motherdeveloper/mother-mls25-hw/README.rst

=====================
Mother MLS12 hardware
=====================

A 12W tunable-white LED driver, powered via PoE.
