motherdeveloper/mother-mls25-hw/pcb/mls25.kicad_pcb

## KiCad design pcb/mls25.kicad_pcb (2025-10-22)

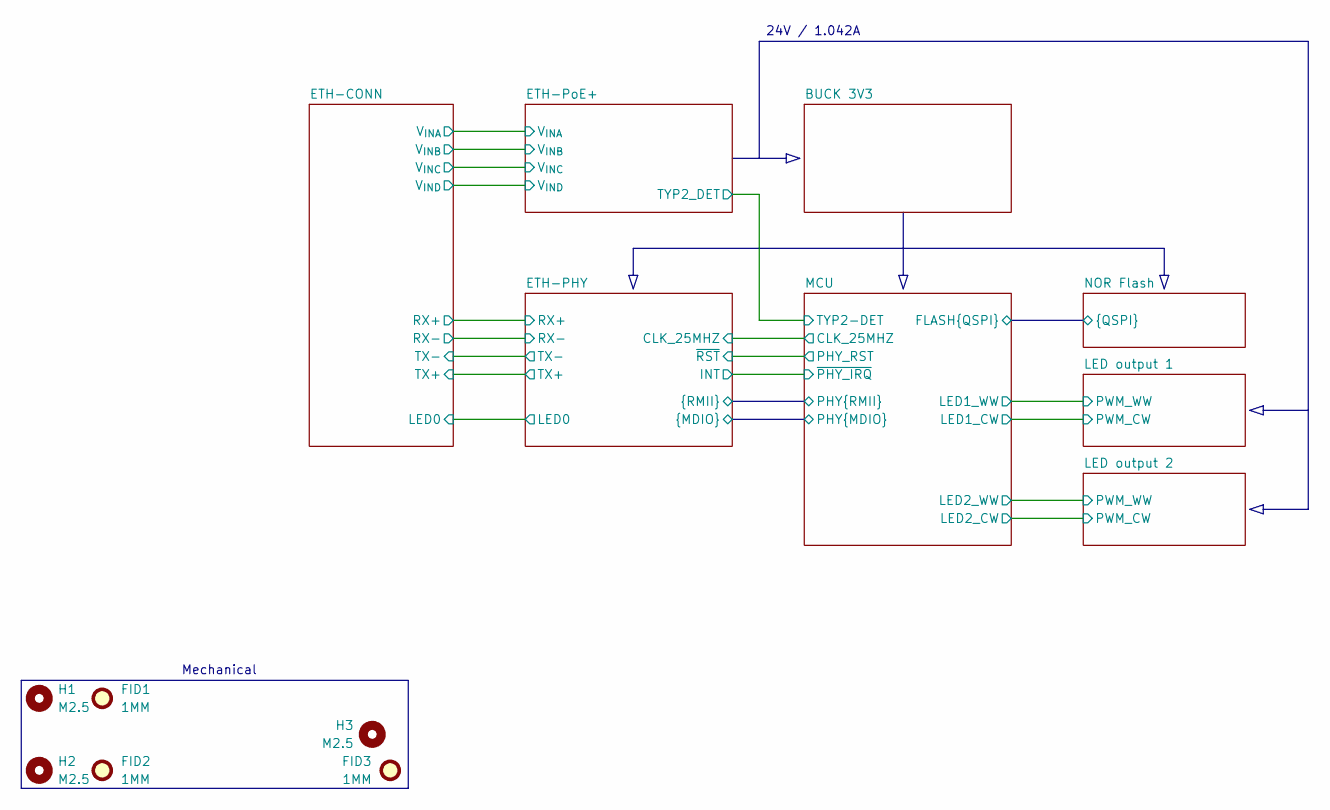
[picture p1: schematic mls25.kicad_sch, MLS25 — PoE+ LED driver]

Parts:
FID1, FID2, FID3: 1MM; Fiducial_1mm_Mask2mm
H1, H2, H3: M2.5; MountingHole_2.7mm_M2.5_ISO7380

Notes on the sheet:
24V / 1.042A
Mechanical

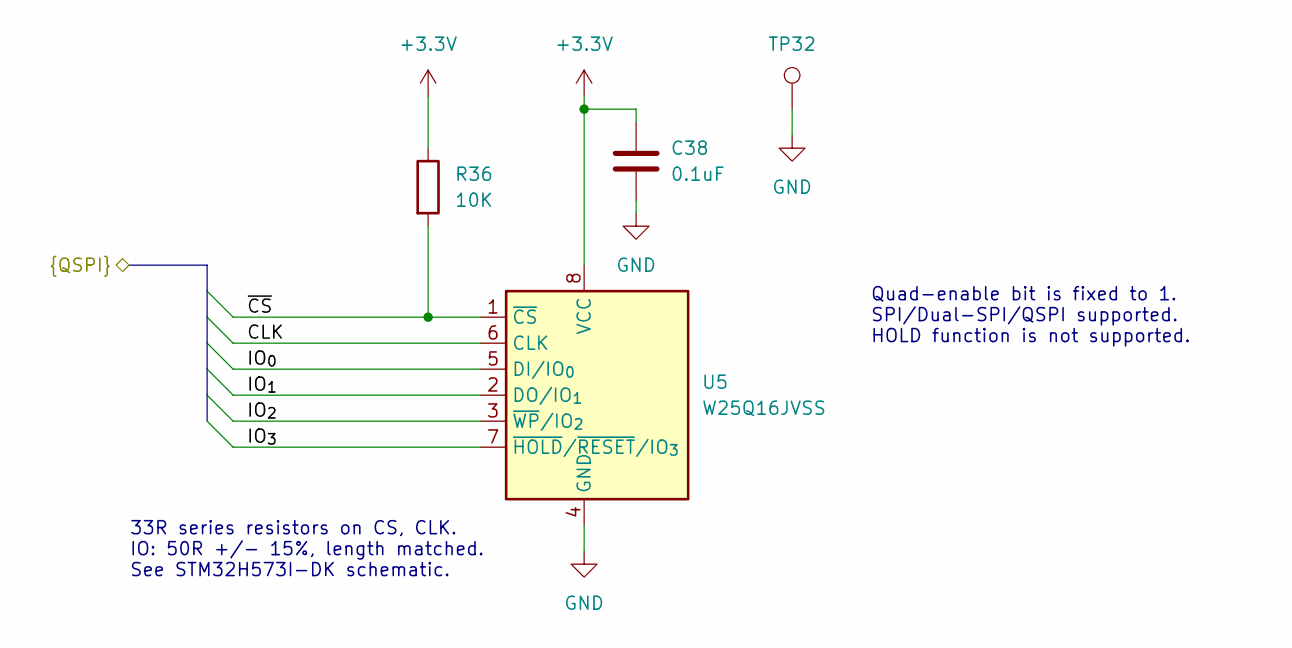
[picture p2: schematic mls25_nor_flash.kicad_sch, NOR flash memory]

Parts:
C38: 0.1uF; C_0603_1608Metric; MPN C0603C104M5RACAUTO
R36: 10K; R_0603_1608Metric; MPN AF0603FR-0710KL
TP32: TestPoint; TestPoint_Pad_1.5x1.5mm
U5: W25Q16JVSS; SOIC-8_5.3x5.3mm_P1.27mm; MPN W25Q16JVSSIQ

Connections:
+3.3V: C38.1, R36.1, U5.8 (VCC); also elsewhere on the board
/MCU/FLASH.CLK: U5.6 (CLK); also elsewhere on the board
/MCU/FLASH.IO_{0}: U5.5 (DI/IO_{0}); also elsewhere on the board
/MCU/FLASH.IO_{1}: U5.2 (DO/IO_{1}); also elsewhere on the board
/MCU/FLASH.IO_{2}: U5.3 (~WP/IO_{2}); also elsewhere on the board
/MCU/FLASH.IO_{3}: U5.7 (~HOLD/~RESET/IO_{3}); also elsewhere on the board
/MCU/FLASH.~CS: R36.2, U5.1 (~CS); also elsewhere on the board
GND: C38.2, TP32.1, U5.4 (GND); also elsewhere on the board

Notes on the sheet:
33R series resistors on CS, CLK. IO: 50R +/- 15%, length matched. See STM32H573I-DK schematic.
Quad-enable bit is fixed to 1. SPI/Dual-SPI/QSPI supported. HOLD function is not supported.

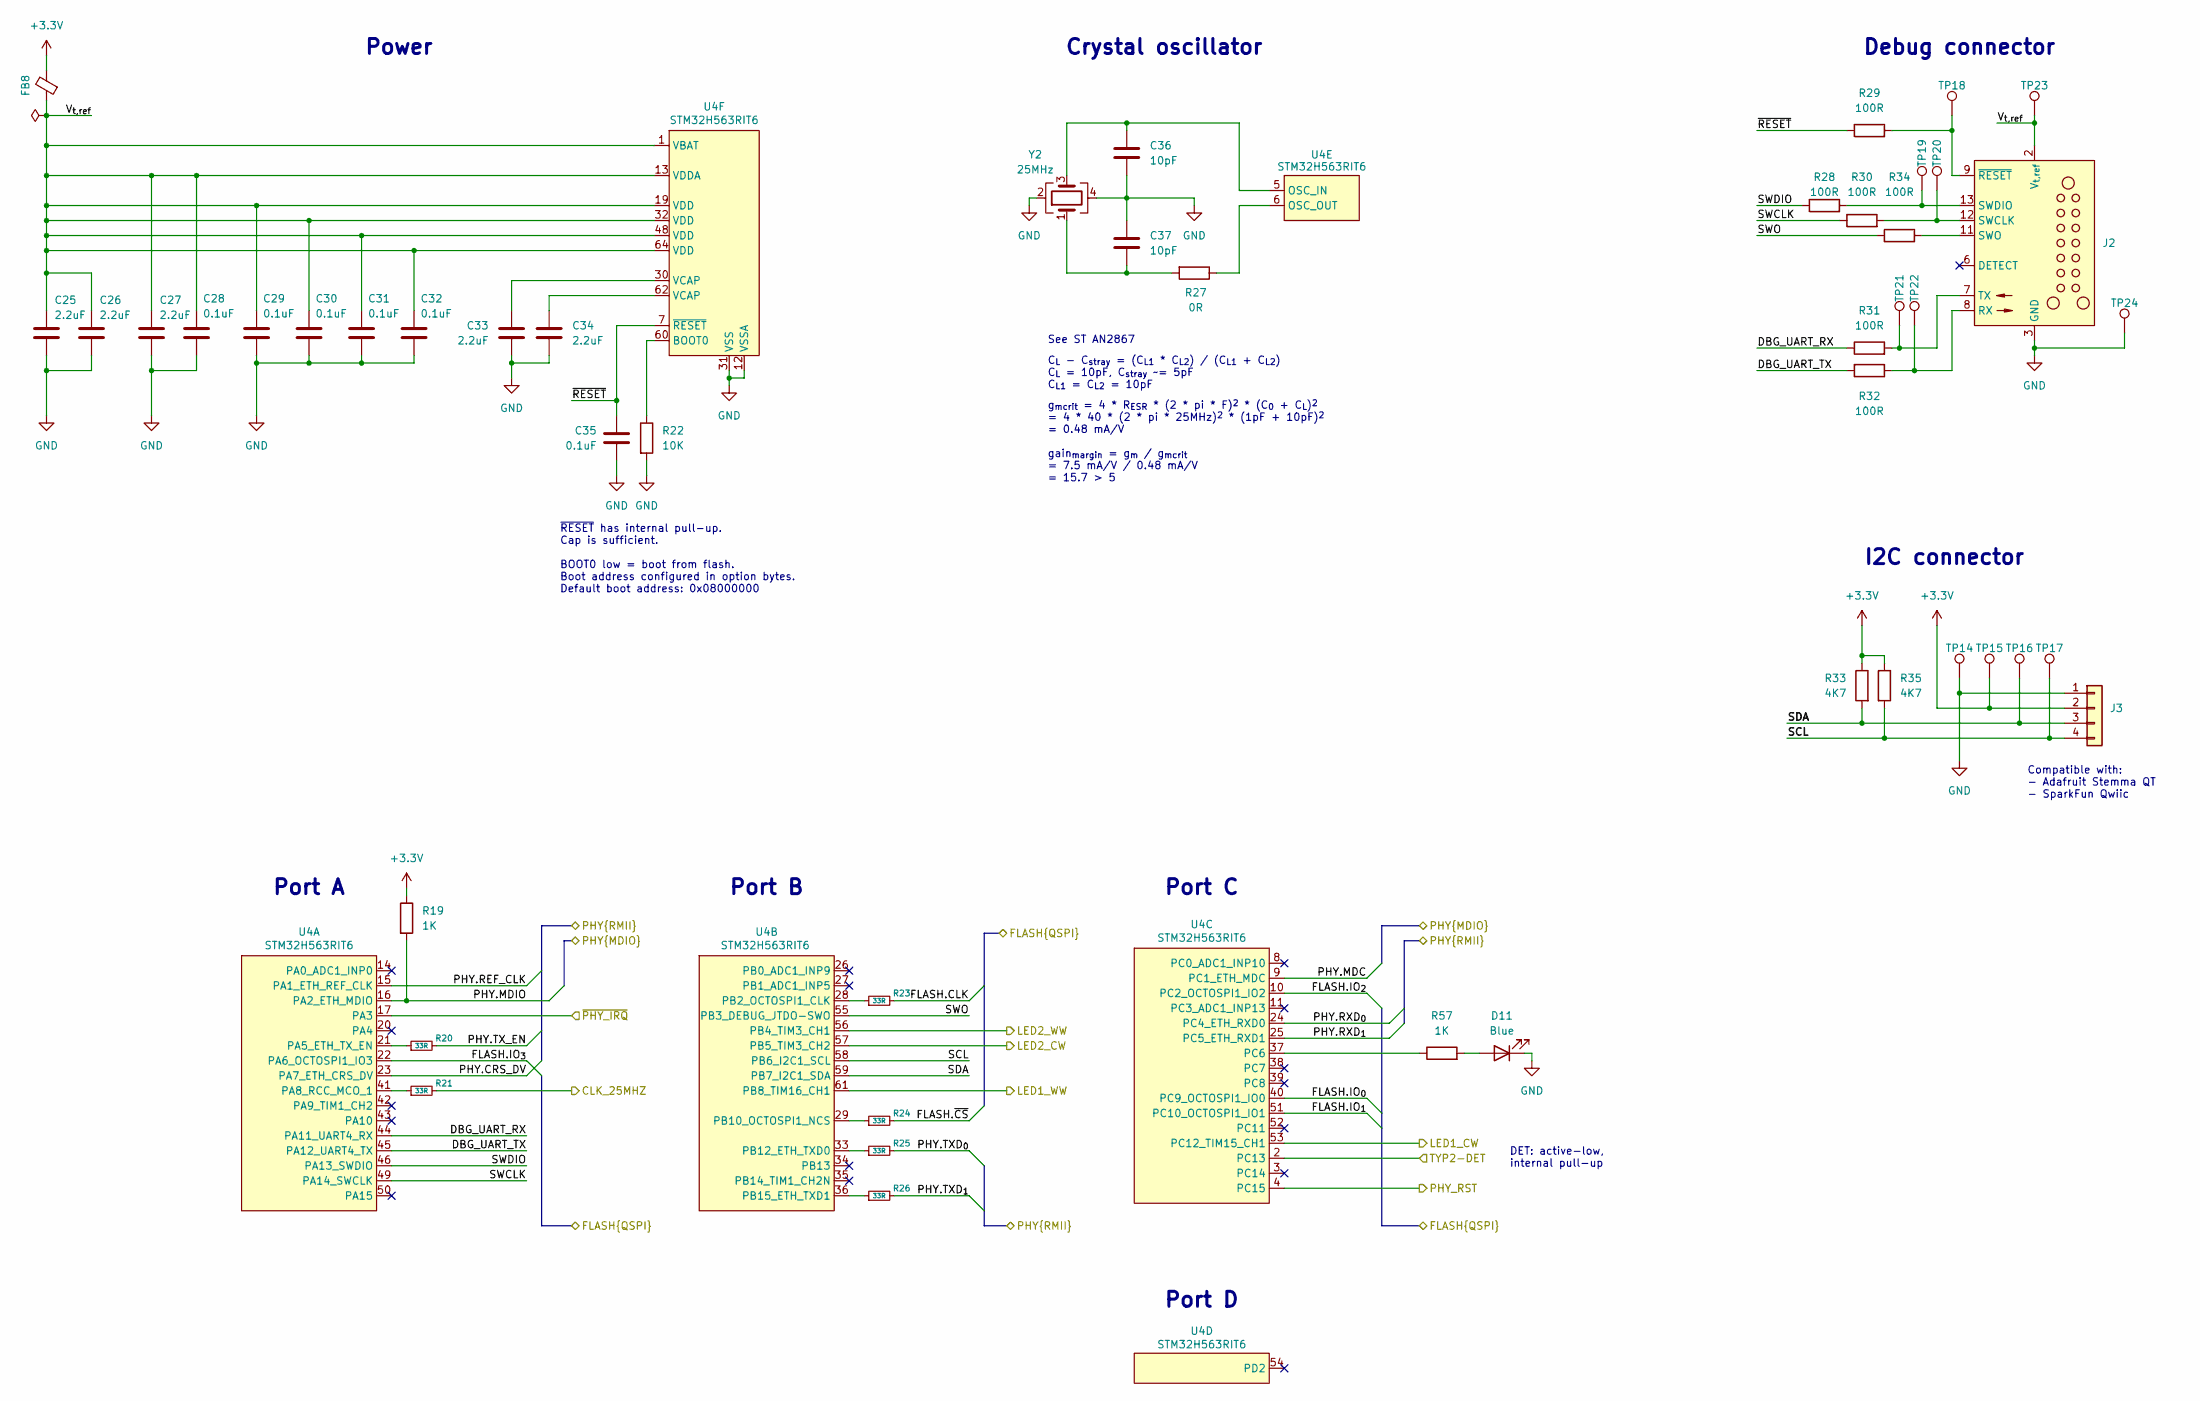
[picture p3: schematic mls25_mcu.kicad_sch, Microcontroller]

Parts:
C25, C26, C27, C33, C34: 2.2uF; C_0603_1608Metric; MPN CL10A225KQ8NNNC
C28, C29, C30, C31, C32, C35: 0.1uF; C_0603_1608Metric; MPN C0603C104M5RACAUTO
C36, C37: 10pF; C_0603_1608Metric; MPN 0603N100J100CT
D11: Blue; LED_0603_1608Metric; MPN LTST-C193TBKT-5A
FB8: FerriteBead_Small; L_0805_2012Metric; MPN MPZ2012S102AT000
J2: TC2070-FP; Tag-Connect_TC2070-IDC-FP_2x07_P1.27mm_Vertical; MPN TC2070-IDC-FP
J3: SM04B-SRSS-TB; JST_SH_SM04B-SRSS-TB_1x04-1MP_P1.00mm_Horizontal; MPN SM04B-SRSS-TB
R19, R57: 1K; R_0603_1608Metric; MPN AC0603JR-131KL
R20, R21, R23, R24, R25, R26: 33R; R_0603_1608Metric; MPN WR06X330 JTL
R22: 10K; R_0603_1608Metric; MPN AF0603FR-0710KL
R27: 0R; R_0603_1608Metric; MPN RC0603JR-100RL
R28, R29, R30, R31, R32, R34: 100R; R_0603_1608Metric; MPN RC0603JR-10100RL
R33, R35: 4K7; R_0603_1608Metric; MPN RC0603JR-134K7L
TP14, TP24: TestPoint; TestPoint_Pad_1.5x1.5mm
TP15, TP16, TP17, TP18, TP19, TP20, TP21, TP22, TP23: TestPoint; TestPoint_Pad_D1.5mm
U4: STM32H563RIT6; LQFP-64_10x10mm_P0.5mm; MPN STM32H563RIT6
Y2: 25MHz; Crystal_SMD_3225-4Pin_3.2x2.5mm; MPN CX3225FB25000F0FZZH1

Connections:
+3.3V: FB8.2, J3.2, R19.1, R33.1, R35.1, TP15.1; also elsewhere on the board
/ETH-PHY/CLK_25MHZ: R21.2; also elsewhere on the board
/ETH-PHY/CRS_DV: U4.23 (PA7_ETH_CRS_DV); also elsewhere on the board
/ETH-PHY/INT: U4.17 (PA3); also elsewhere on the board
/ETH-PHY/MDC: U4.9 (PC1_ETH_MDC); also elsewhere on the board
/ETH-PHY/MDIO: R19.2, U4.16 (PA2_ETH_MDIO); also elsewhere on the board
/ETH-PHY/REF_CLK: U4.15 (PA1_ETH_REF_CLK); also elsewhere on the board
/ETH-PHY/RXD_{0}: U4.24 (PC4_ETH_RXD0); also elsewhere on the board
/ETH-PHY/RXD_{1}: U4.25 (PC5_ETH_RXD1); also elsewhere on the board
/ETH-PHY/TXD_{0}: R25.2; also elsewhere on the board
/ETH-PHY/TXD_{1}: R26.2; also elsewhere on the board
/ETH-PHY/TX_EN: R20.2; also elsewhere on the board
/ETH-PHY/~RST: U4.4 (PC15); also elsewhere on the board
/ETH-PoE+/TYP2_DET: U4.2 (PC13); also elsewhere on the board
/LED output 1/PWM_CW: U4.53 (PC12_TIM15_CH1); also elsewhere on the board
/LED output 1/PWM_WW: U4.61 (PB8_TIM16_CH1); also elsewhere on the board
/LED output 2/PWM_CW: U4.57 (PB5_TIM3_CH2); also elsewhere on the board
/LED output 2/PWM_WW: U4.56 (PB4_TIM3_CH1); also elsewhere on the board
/MCU/DBG_UART_RX: R31.1, U4.44 (PA11_UART4_RX)
/MCU/DBG_UART_TX: R32.2, U4.45 (PA12_UART4_TX)
/MCU/FLASH.CLK: R23.2; also elsewhere on the board
/MCU/FLASH.IO_{0}: U4.40 (PC9_OCTOSPI1_IO0); also elsewhere on the board
/MCU/FLASH.IO_{1}: U4.51 (PC10_OCTOSPI1_IO1); also elsewhere on the board
/MCU/FLASH.IO_{2}: U4.10 (PC2_OCTOSPI1_IO2); also elsewhere on the board
/MCU/FLASH.IO_{3}: U4.22 (PA6_OCTOSPI1_IO3); also elsewhere on the board
/MCU/FLASH.~CS: R24.2; also elsewhere on the board
/MCU/SCL: J3.4, R35.2, TP17.1, U4.58 (PB6_I2C1_SCL)
/MCU/SDA: J3.3, R33.2, TP16.1, U4.59 (PB7_I2C1_SDA)
/MCU/SWCLK: R30.1, U4.49 (PA14_SWCLK)
/MCU/SWDIO: R28.1, U4.46 (PA13_SWDIO)
/MCU/SWO: R34.1, U4.55 (PB3_DEBUG_JTDO-SWO)
/MCU/V_{t,ref}: C25.1, C26.1, C27.1, C28.1, C29.1, C30.1, C31.1, C32.1, FB8.1, J2.2 (V_{t,ref}), TP23.1, U4.1 (VBAT), U4.13 (VDDA), U4.19 (VDD), U4.32 (VDD), U4.48 (VDD), U4.64 (VDD)
/MCU/~RESET: C35.1, R29.1, U4.7 (~RESET)
GND: C25.2, C26.2, C27.2, C28.2, C29.2, C30.2, C31.2, C32.2, C33.2, C34.2, C35.2, C36.2, C37.1, D11.1 (K), J2.3 (GND), J2.4 (GND), J3.1, R22.2, TP14.1, TP24.1, U4.12 (VSSA), U4.18 (VSSA), U4.31 (VSS), U4.47 (VSS), U4.63 (VSS), Y2.2, Y2.4; also elsewhere on the board
unnamed: C33.1, U4.30 (VCAP)
unnamed: C34.1, U4.62 (VCAP)
unnamed: C37.2, R27.2, Y2.1
unnamed: D11.2 (A), R57.2
unnamed: J2.8 (RX), R32.1, TP22.1
unnamed: J2.12 (SWCLK), R30.2, TP20.1
unnamed: J2.13 (SWDIO), R28.2, TP19.1
unnamed: J2.11 (SWO), R34.2
unnamed: J2.7 (TX), R31.2, TP21.1
unnamed: J2.9 (~RESET), R29.2, TP18.1
unnamed: R20.1, U4.21 (PA5_ETH_TX_EN)
unnamed: R21.1, U4.41 (PA8_RCC_MCO_1)
unnamed: R23.1, U4.28 (PB2_OCTOSPI1_CLK)
unnamed: R24.1, U4.29 (PB10_OCTOSPI1_NCS)
unnamed: R25.1, U4.33 (PB12_ETH_TXD0)
unnamed: R26.1, U4.36 (PB15_ETH_TXD1)
unnamed: R57.1, U4.37 (PC6)
unnamed: C36.1, U4.5 (OSC_IN), Y2.3
unnamed: R27.1, U4.6 (OSC_OUT)
unnamed: R22.1, U4.60 (BOOT0)

Notes on the sheet:
C_{L} - C_{stray} = (C_{L1} * C_{L2}) / (C_{L1} + C_{L2}) C_{L} = 10pF, C_{stray} ~= 5pF C_{L1} = C_{L2} = 10pF
See ST AN2867
I2C connector
g_{mcrit} = 4 * R_{ESR} * (2 * pi * F)^{2} * (C_{0} + C_{L})^{2} = 4 * 40 * (2 * pi * 25MHz)^{2} * (1pF + 10pF)^{2} = 0.48 mA/V gain_{margin} = g_{m} / g_{mcrit} = 7.5 mA/V / 0.48 mA/V = 15.7 > 5
Debug connector
Crystal oscillator
Power
Port A
Compatible with: - Adafruit Stemma QT - SparkFun Qwiic
Port D
Port C
Port B
DET: active-low, internal pull-up
~{RESET} has internal pull-up. Cap is sufficient. BOOT0 low = boot from flash. Boot address configured in option bytes. Default boot address: 0x08000000

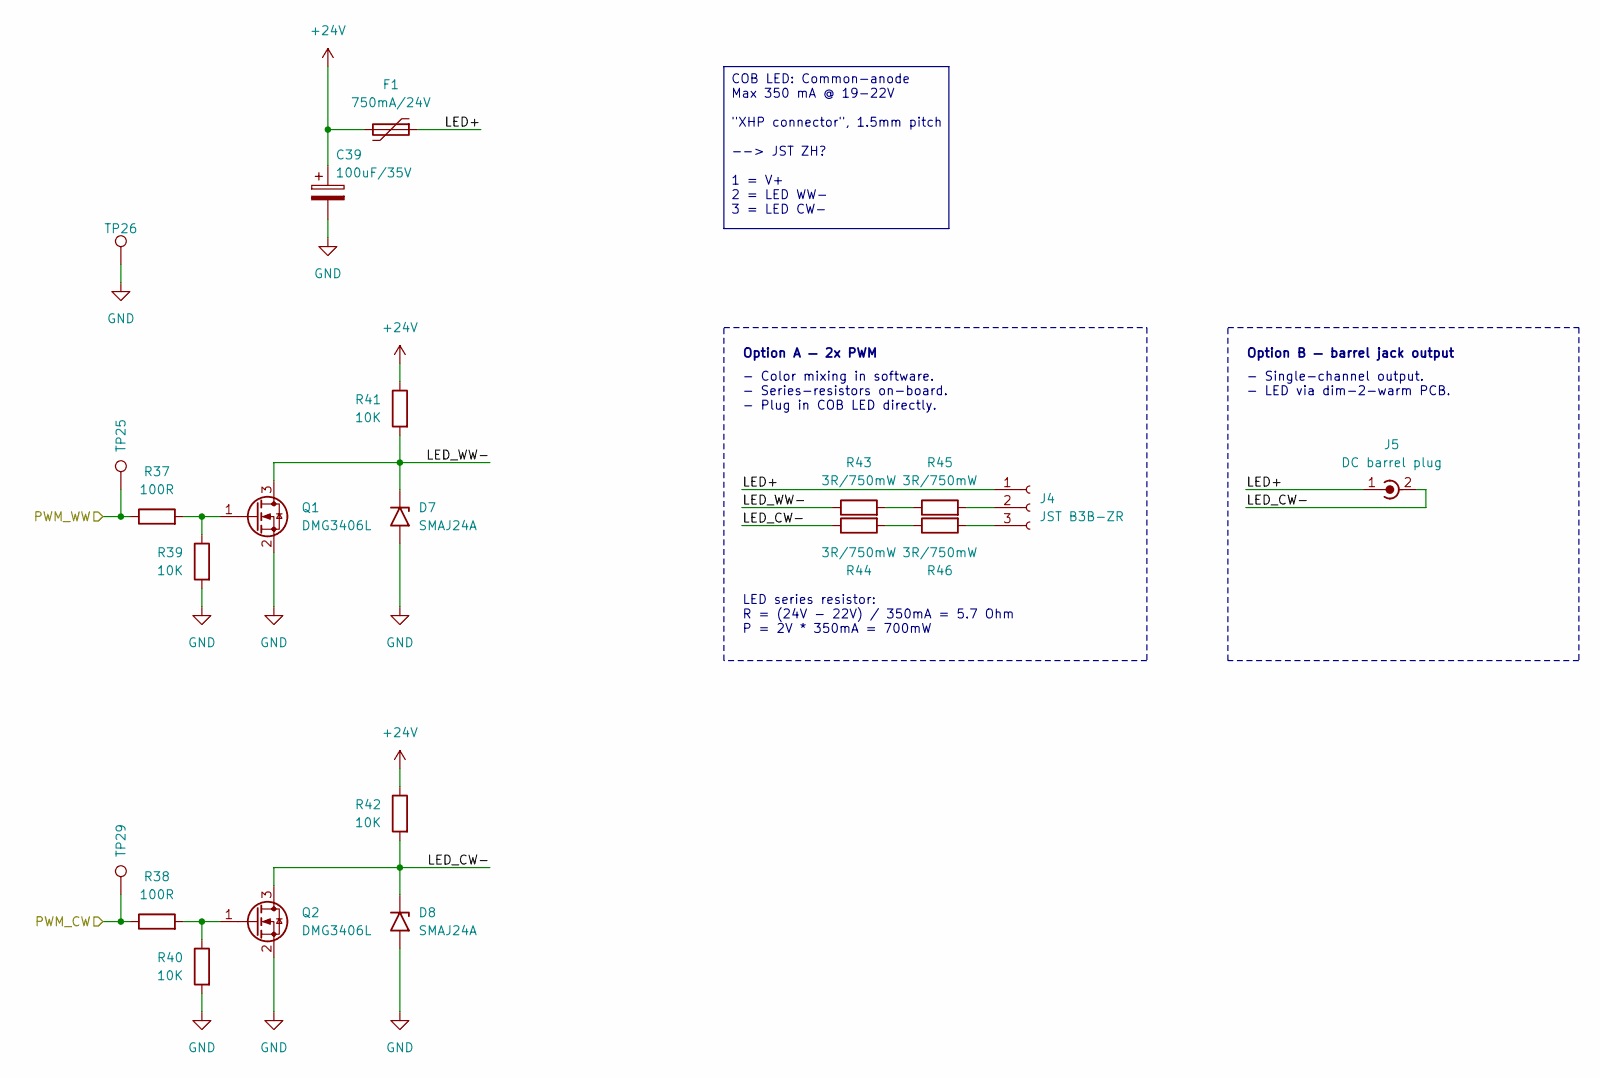
[picture p4: schematic mls25_led_output.kicad_sch, LED output]

Parts:
C39: 100uF/35V; CP_Elec_6.3x5.9; MPN 865080545012
D7, D8: SMAJ24A; D_SMA; MPN SMBJ24A/TR13
F1: 750mA/24V; SMD1812B050TF_30; MPN SMD1812B075TF/24
J4: JST B3B-ZR; JST_ZH_B3B-ZR_1x03_P1.50mm_Vertical; MPN B3B-ZR
J5: DC barrel plug; DC_Barrel_Plug_2.1x5.5mm
Q1, Q2: DMG3406L; SOT-23; MPN DMG3406L-13
R37, R38: 100R; R_0603_1608Metric; MPN RC0603JR-10100RL
R39, R40, R41, R42: 10K; R_0603_1608Metric; MPN AF0603FR-0710KL
R43, R44, R45, R46: 3R/750mW; R_1206_3216Metric; MPN ESR18EZPF3R00
TP25, TP29: TestPoint; TestPoint_Pad_D1.5mm
TP26: TestPoint; TestPoint_Pad_1.5x1.5mm

Connections:
+24V: C39.1, F1.2, R41.1, R42.1; also elsewhere on the board
/LED output 1/LED+: F1.1, J4.1, J5.1 (In)
/LED output 1/LED_CW-: D8.1 (A1), J5.2 (Ext), Q2.3 (D), R42.2, R44.1
/LED output 1/LED_WW-: D7.1 (A1), Q1.3 (D), R41.2, R43.1
/LED output 1/PWM_CW: R38.1, TP29.1; also elsewhere on the board
/LED output 1/PWM_WW: R37.1, TP25.1; also elsewhere on the board
GND: C39.2, D7.2 (A2), D8.2 (A2), Q1.2 (S), Q2.2 (S), R39.2, R40.2, TP26.1; also elsewhere on the board
unnamed: J4.2, R45.2
unnamed: J4.3, R46.2
unnamed: Q1.1 (G), R37.2, R39.1
unnamed: Q2.1 (G), R38.2, R40.1
unnamed: R43.2, R45.1
unnamed: R44.2, R46.1

Parts of its further copies:
C40: 100uF/35V; CP_Elec_6.3x5.9; MPN 865080545012
D9, D10: SMAJ24A; D_SMA; MPN SMBJ24A/TR13
F2: 750mA/24V; SMD1812B050TF_30; MPN SMD1812B075TF/24
J6: JST B3B-ZR; JST_ZH_B3B-ZR_1x03_P1.50mm_Vertical; MPN B3B-ZR
J7: DC barrel plug; DC_Barrel_Plug_2.1x5.5mm
Q3, Q4: DMG3406L; SOT-23; MPN DMG3406L-13
R47, R48: 100R; R_0603_1608Metric; MPN RC0603JR-10100RL
R49, R50, R51, R52: 10K; R_0603_1608Metric; MPN AF0603FR-0710KL
R53, R54, R55, R56: 3R/750mW; R_1206_3216Metric; MPN ESR18EZPF3R00
TP27, TP30: TestPoint; TestPoint_Pad_D1.5mm
TP28: TestPoint; TestPoint_Pad_1.5x1.5mm

Connections of its further copies:
+24V: C40.1, F2.2, R51.1, R52.1; also elsewhere on the board
/LED output 2/LED+: F2.1, J6.1, J7.1 (In)
/LED output 2/LED_CW-: D10.1 (A1), J7.2 (Ext), Q4.3 (D), R52.2, R54.1
/LED output 2/LED_WW-: D9.1 (A1), Q3.3 (D), R51.2, R53.1
/LED output 2/PWM_CW: R48.1, TP30.1; also elsewhere on the board
/LED output 2/PWM_WW: R47.1, TP27.1; also elsewhere on the board
GND: C40.2, D9.2 (A2), D10.2 (A2), Q3.2 (S), Q4.2 (S), R49.2, R50.2, TP28.1; also elsewhere on the board
unnamed: J6.2, R55.2
unnamed: J6.3, R56.2
unnamed: Q3.1 (G), R47.2, R49.1
unnamed: Q4.1 (G), R48.2, R50.1
unnamed: R53.2, R55.1
unnamed: R54.2, R56.1

Notes on the sheet:
Option A — 2x PWM
- Color mixing in software. - Series-resistors on-board. - Plug in COB LED directly.
LED series resistor: R = (24V - 22V) / 350mA = 5.7 Ohm P = 2V * 350mA = 700mW
Option B — barrel jack output
- Single-channel output. - LED via dim-2-warm PCB.
COB LED: Common-anode Max 350 mA @ 19-22V "XHP connector", 1.5mm pitch --> JST ZH? 1 = V+ 2 = LED WW- 3 = LED CW-

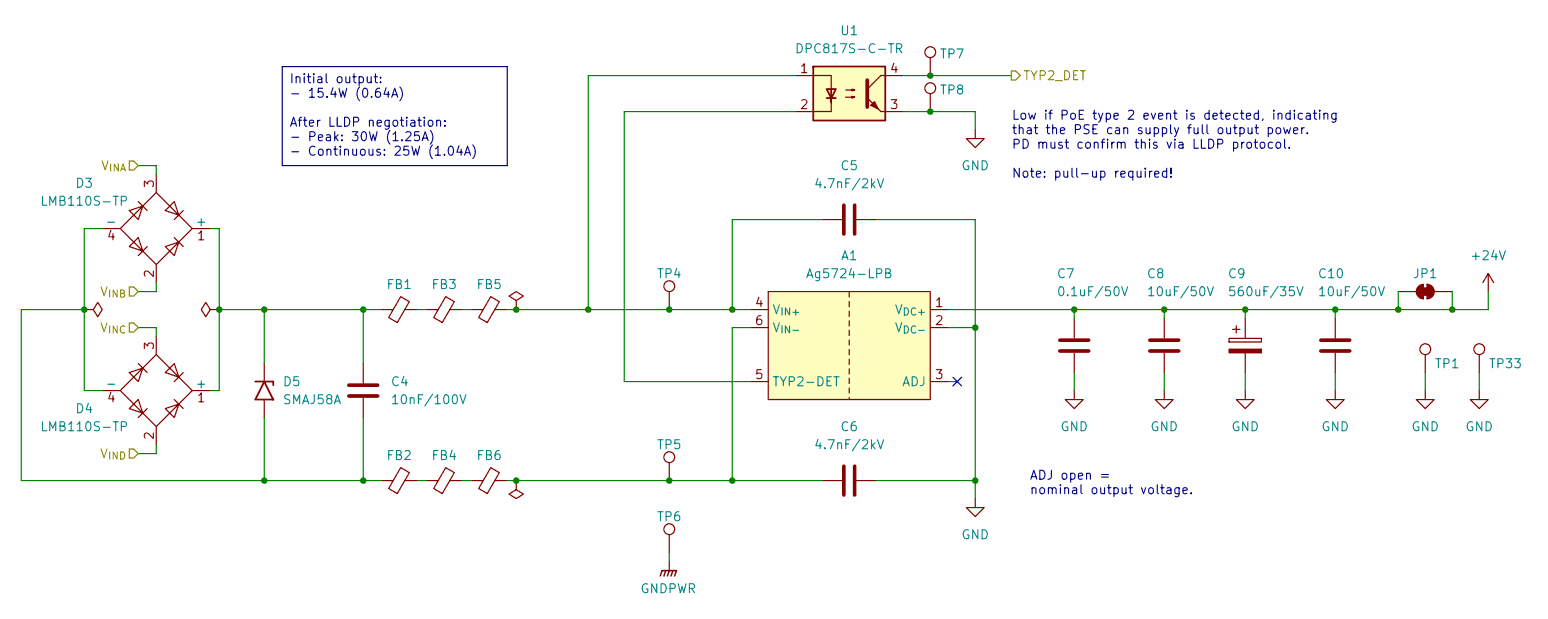
[picture p5: schematic mls25_eth_poe.kicad_sch, Power-over-Ethernet]

Parts:
A1: Ag5724-LPB; MPN Ag5724-LPB
C4: 10nF/100V; C_0603_1608Metric; MPN CGA3E2X7R2A103K080AA
C5, C6: 4.7nF/2kV; C_1210_3225Metric; MPN 1210B472K202CT
C7: 0.1uF/50V; C_0603_1608Metric; MPN C0603C104M5RACAUTO
C8, C10: 10uF/50V; C_1206_3216Metric; MPN 1206X106K500CT
C9: 560uF/35V; CP_Elec_10x10.5; MPN EMZS350ARA561MJA0G
D3, D4: LMB110S-TP; MPN LMB110S-TP
D5: SMAJ58A; D_SMA; MPN SMAJ58A/TR13
FB1, FB2, FB3, FB4, FB5, FB6: FerriteBead_Small; L_0805_2012Metric; MPN MPZ2012S102AT000
JP1: SolderJumper_2_Bridged; SolderJumper-2_P1.3mm_Bridged_RoundedPad1.0x1.5mm
TP1, TP6, TP8, TP33: TestPoint; TestPoint_Pad_1.5x1.5mm
TP4, TP5, TP7: TestPoint; TestPoint_Pad_D1.5mm
U1: DPC817S-C-TR; MPN DPC817S-C-TR

Connections:
+24V: A1.1 (V_{DC+}), C7.1, C8.1, C9.1, C10.1, JP1.1 (A), JP1.2 (B); also elsewhere on the board
/ETH-CONN/V_{INA}: D3.3; also elsewhere on the board
/ETH-CONN/V_{INB}: D3.2; also elsewhere on the board
/ETH-CONN/V_{INC}: D4.3; also elsewhere on the board
/ETH-CONN/V_{IND}: D4.2; also elsewhere on the board
/ETH-PoE+/TYP2_DET: TP7.1, U1.4; also elsewhere on the board
GND: A1.2 (V_{DC-}), C5.2, C6.2, C7.2, C8.2, C9.2, C10.2, TP1.1, TP8.1, TP33.1, U1.3; also elsewhere on the board
GNDPWR: TP6.1; also elsewhere on the board
unnamed: A1.5 (TYP2-DET), U1.2
unnamed: A1.4 (V_{IN+}), C5.1, FB5.2, TP4.1, U1.1
unnamed: A1.6 (V_{IN-}), C6.1, FB6.2, TP5.1
unnamed: C4.1, D3.1 (+), D4.1 (+), D5.1 (A1), FB1.1
unnamed: C4.2, D3.4 (-), D4.4 (-), D5.2 (A2), FB2.1
unnamed: FB1.2, FB3.1
unnamed: FB2.2, FB4.1
unnamed: FB3.2, FB5.1
unnamed: FB4.2, FB6.1

Notes on the sheet:
Low if PoE type 2 event is detected, indicating that the PSE can supply full output power. PD must confirm this via LLDP protocol. Note: pull-up required!
ADJ open = nominal output voltage.
Initial output: - 15.4W (0.64A) After LLDP negotiation: - Peak: 30W (1.25A) - Continuous: 25W (1.04A)

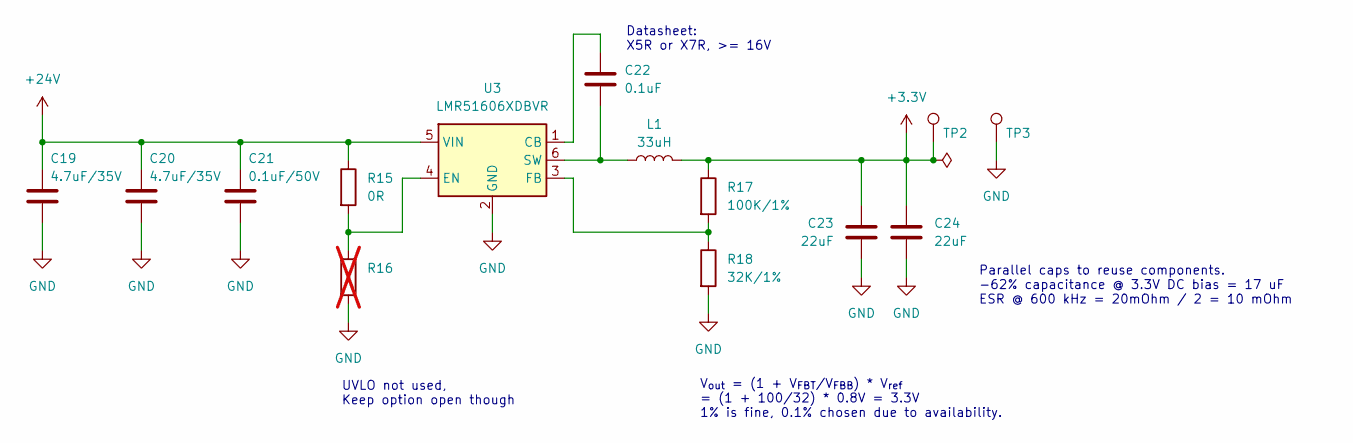
[picture p6: schematic mls25_buck_3v3.kicad_sch, 3.3V buck-converter]

Parts:
C19, C20: 4.7uF/35V; C_0603_1608Metric; MPN C1608X5R1V475K080AC
C21: 0.1uF/50V; C_0603_1608Metric; MPN C0603C104M5RACAUTO
C22: 0.1uF; C_0603_1608Metric; MPN C0603C104M5RACAUTO
C23, C24: 22uF; C_0603_1608Metric; MPN GRM188R60J226MEA0J
L1: 33uH; L_Taiyo-Yuden_NR-60xx; MPN NRS6045T330MMGK
R15: 0R; R_0603_1608Metric; MPN RC0603JR-100RL
R16: R_0603_1608Metric; not fitted
R17: 100K/1%; R_0603_1608Metric; MPN RT0603FRE13100KL
R18: 32K/1%; R_0603_1608Metric; MPN RT0603BRD0732KL
TP2: TestPoint; TestPoint_Pad_D1.5mm
TP3: TestPoint; TestPoint_Pad_1.5x1.5mm
U3: LMR51606XDBVR; LMR51606_SOT-23-6; MPN LMR51606XDBVR

Connections:
+3.3V: C23.1, C24.1, L1.2, R17.1, TP2.1; also elsewhere on the board
+24V: C19.1, C20.1, C21.1, R15.1, U3.5 (VIN); also elsewhere on the board
GND: C19.2, C20.2, C21.2, C23.2, C24.2, R16.2, R18.2, TP3.1, U3.2 (GND); also elsewhere on the board
unnamed: C22.1, U3.1 (CB)
unnamed: R15.2, R16.1, U3.4 (EN)
unnamed: R17.2, R18.1, U3.3 (FB)
unnamed: C22.2, L1.1, U3.6 (SW)

Notes on the sheet:
UVLO not used, Keep option open though
Parallel caps to reuse components. -62% capacitance @ 3.3V DC bias = 17 uF ESR @ 600 kHz = 20mOhm / 2 = 10 mOhm
Datasheet: X5R or X7R, >= 16V
V_{out} = (1 + V_{FBT}/V_{FBB}) * V_{ref} = (1 + 100/32) * 0.8V = 3.3V 1% is fine, 0.1% chosen due to availability.

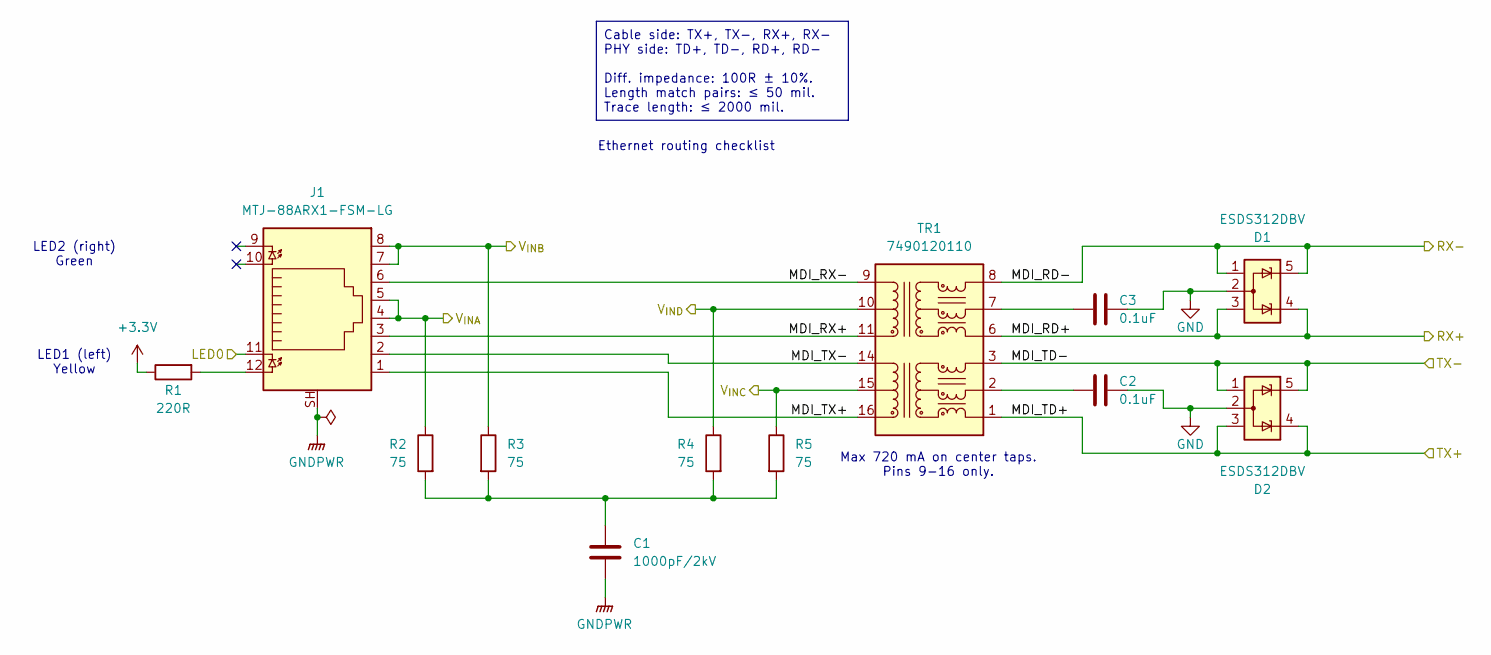
[picture p7: schematic mls25_eth_conn.kicad_sch, Ethernet RJ45 + Magnetics]

Parts:
C1: 1000pF/2kV; C_1206_3216Metric; MPN 885342208024
C2, C3: 0.1uF; C_0603_1608Metric; MPN C0603C104M5RACAUTO
D1, D2: ESDS312DBV; SOT-23-5; MPN ESDS312DBVR
J1: MTJ-88ARX1-FSM-LG; RJ45_Amphenol_RJHSE538X; MPN MTJ-88ARX1-FSM-LG
R1: 220R; R_0603_1608Metric; MPN RC0603JR-07220RL
R2, R3, R4, R5: 75; R_0603_1608Metric; MPN WR06X75R0FTL
TR1: 7490120110; MPN 7490120110

Connections:
+3.3V: R1.1; also elsewhere on the board
/ETH-CONN/LED0: J1.11; also elsewhere on the board
/ETH-CONN/MDI_RD+: D1.3 (NC), D1.4 (K), TR1.6 (RD+); also elsewhere on the board
/ETH-CONN/MDI_RD-: D1.1 (NC), D1.5 (K), TR1.8 (RD-); also elsewhere on the board
/ETH-CONN/MDI_RX+: J1.3, TR1.11 (RX+)
/ETH-CONN/MDI_RX-: J1.6, TR1.9 (RX-)
/ETH-CONN/MDI_TD+: D2.3 (NC), D2.4 (K), TR1.1 (TD+); also elsewhere on the board
/ETH-CONN/MDI_TD-: D2.1 (NC), D2.5 (K), TR1.3 (TD-); also elsewhere on the board
/ETH-CONN/MDI_TX+: J1.1, TR1.16 (TX+)
/ETH-CONN/MDI_TX-: J1.2, TR1.14 (TX-)
/ETH-CONN/V_{INA}: J1.4, J1.5, R2.1; also elsewhere on the board
/ETH-CONN/V_{INB}: J1.7, J1.8, R3.1; also elsewhere on the board
/ETH-CONN/V_{INC}: R5.1, TR1.15 (CTX); also elsewhere on the board
/ETH-CONN/V_{IND}: R4.1, TR1.10 (CRX); also elsewhere on the board
GND: C2.2, C3.2, D1.2 (A), D2.2 (A); also elsewhere on the board
GNDPWR: C1.2, J1.SH; also elsewhere on the board
unnamed: C1.1, R2.2, R3.2, R4.2, R5.2
unnamed: J1.12, R1.2
unnamed: C3.1, TR1.7 (CRD)
unnamed: C2.1, TR1.2 (CTD)

Notes on the sheet:
Ethernet routing checklist
Max 720 mA on center taps. Pins 9-16 only.
LED1 (left) Yellow
LED2 (right) Green
Cable side: TX+, TX-, RX+, RX- PHY side: TD+, TD-, RD+, RD- Diff. impedance: 100R ± 10%. Length match pairs: ≤ 50 mil. Trace length: ≤ 2000 mil.

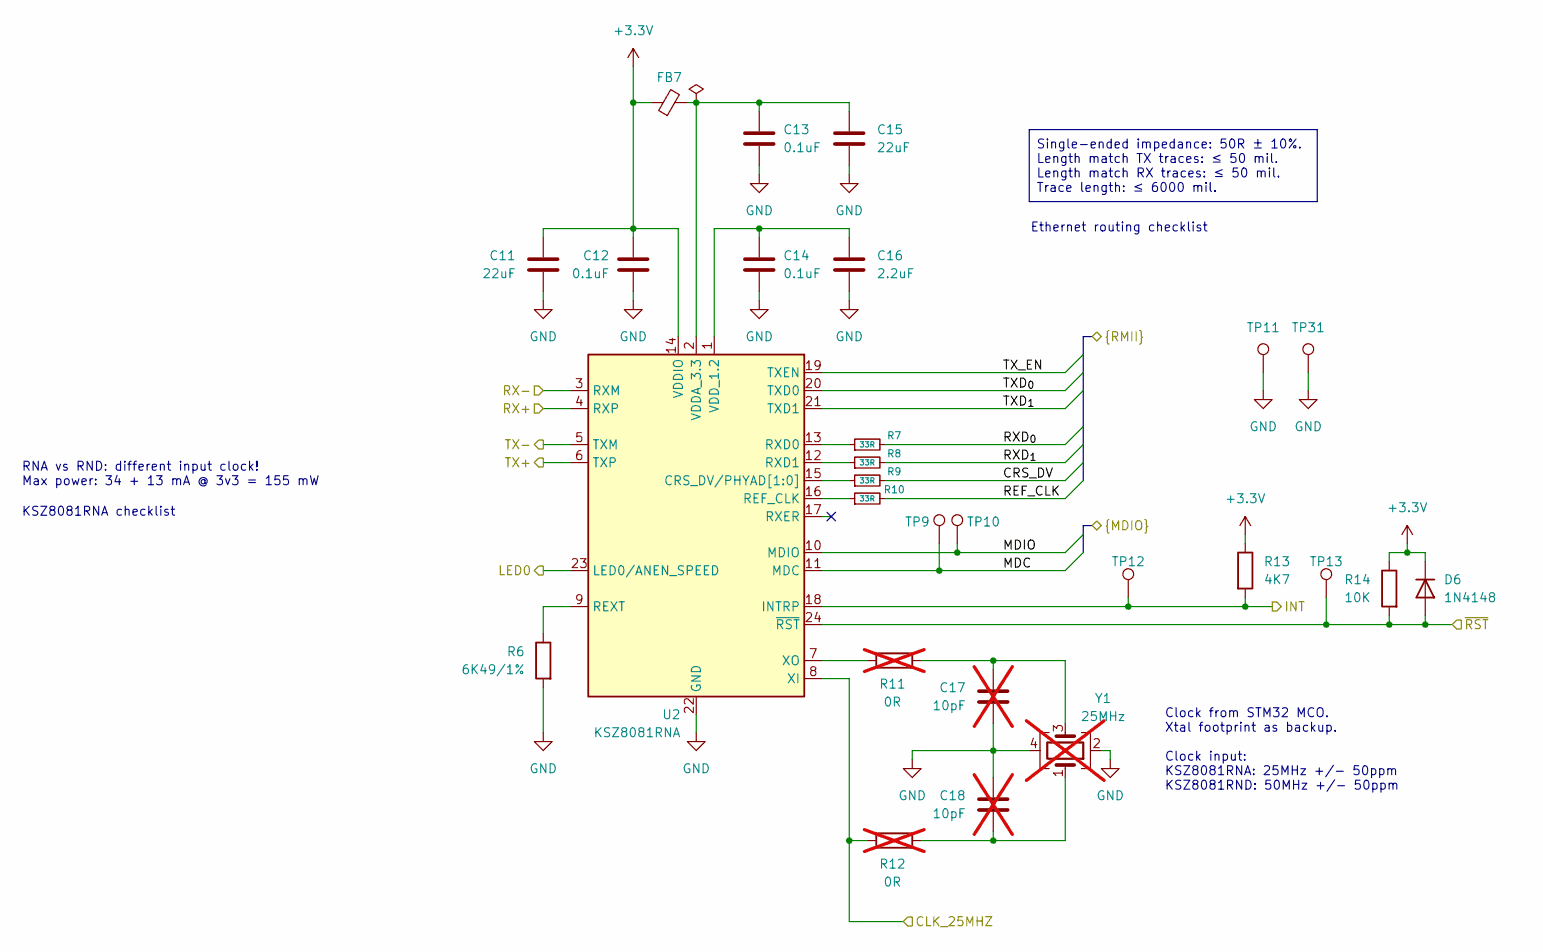
[picture p8: schematic mls25_eth_phy.kicad_sch, Ethernet PHY]

Parts:
C11, C15: 22uF; C_0603_1608Metric; MPN GRM188R60J226MEA0J
C12, C13, C14: 0.1uF; C_0603_1608Metric; MPN C0603C104M5RACAUTO
C16: 2.2uF; C_0603_1608Metric; MPN CL10A225KQ8NNNC
C17, C18: 10pF; C_0603_1608Metric; MPN 0603N100J100CT; not fitted
D6: 1N4148; D_SOD-523; MPN 1N4148WT
FB7: FerriteBead_Small; L_0805_2012Metric; MPN MPZ2012S102AT000
R6: 6K49/1%; R_0603_1608Metric; MPN CR0603-FX-6491ELF
R7, R8, R9, R10: 33R; R_0603_1608Metric; MPN WR06X330 JTL
R11, R12: 0R; R_0603_1608Metric; MPN RC0603JR-100RL; not fitted
R13: 4K7; R_0603_1608Metric; MPN RC0603JR-134K7L
R14: 10K; R_0603_1608Metric; MPN AF0603FR-0710KL
TP9, TP10, TP12, TP13: TestPoint; TestPoint_Pad_D1.5mm
TP11, TP31: TestPoint; TestPoint_Pad_1.5x1.5mm
U2: KSZ8081RNA; KSZ8081_QFN-24-1EP_4x4mm_P0.5mm_EP2.6x2.6mm; MPN KSZ8081RNACA
Y1: 25MHz; Crystal_SMD_3225-4Pin_3.2x2.5mm; MPN CX3225FB25000F0FZZH1; not fitted

Connections:
+3.3V: C11.1, C12.1, D6.1 (K), FB7.1, R13.1, R14.1, U2.14 (VDDIO); also elsewhere on the board
/ETH-CONN/LED0: U2.23 (LED0/ANEN_SPEED); also elsewhere on the board
/ETH-CONN/MDI_RD+: U2.4 (RXP); also elsewhere on the board
/ETH-CONN/MDI_RD-: U2.3 (RXM); also elsewhere on the board
/ETH-CONN/MDI_TD+: U2.6 (TXP); also elsewhere on the board
/ETH-CONN/MDI_TD-: U2.5 (TXM); also elsewhere on the board
/ETH-PHY/CLK_25MHZ: R12.1, U2.8 (XI); also elsewhere on the board
/ETH-PHY/CRS_DV: R9.2; also elsewhere on the board
/ETH-PHY/INT: R13.2, TP12.1, U2.18 (INTRP); also elsewhere on the board
/ETH-PHY/MDC: TP9.1, U2.11 (MDC); also elsewhere on the board
/ETH-PHY/MDIO: TP10.1, U2.10 (MDIO); also elsewhere on the board
/ETH-PHY/REF_CLK: R10.2; also elsewhere on the board
/ETH-PHY/RXD_{0}: R7.2; also elsewhere on the board
/ETH-PHY/RXD_{1}: R8.2; also elsewhere on the board
/ETH-PHY/TXD_{0}: U2.20 (TXD0); also elsewhere on the board
/ETH-PHY/TXD_{1}: U2.21 (TXD1); also elsewhere on the board
/ETH-PHY/TX_EN: U2.19 (TXEN); also elsewhere on the board
/ETH-PHY/~RST: D6.2 (A), R14.2, TP13.1, U2.24 (~RST); also elsewhere on the board
GND: C11.2, C12.2, C13.2, C14.2, C15.2, C16.2, C17.2, C18.1, R6.2, TP11.1, TP31.1, U2.22 (GND), U2.25 (GND), Y1.2, Y1.4; also elsewhere on the board
unnamed: C17.1, R11.2, Y1.3
unnamed: C18.2, R12.2, Y1.1
unnamed: R9.1, U2.15 (CRS_DV/PHYAD[1:0])
unnamed: R10.1, U2.16 (REF_CLK)
unnamed: R6.1, U2.9 (REXT)
unnamed: R7.1, U2.13 (RXD0)
unnamed: R8.1, U2.12 (RXD1)
unnamed: C13.1, C15.1, FB7.2, U2.2 (VDDA_3.3)
unnamed: C14.1, C16.1, U2.1 (VDD_1.2)
unnamed: R11.1, U2.7 (XO)

Notes on the sheet:
Ethernet routing checklist
RNA vs RND: different input clock! Max power: 34 + 13 mA @ 3v3 = 155 mW
Clock from STM32 MCO. Xtal footprint as backup. Clock input: KSZ8081RNA: 25MHz +/- 50ppm KSZ8081RND: 50MHz +/- 50ppm
KSZ8081RNA checklist
Single-ended impedance: 50R ± 10%. Length match TX traces: ≤ 50 mil. Length match RX traces: ≤ 50 mil. Trace length: ≤ 6000 mil.

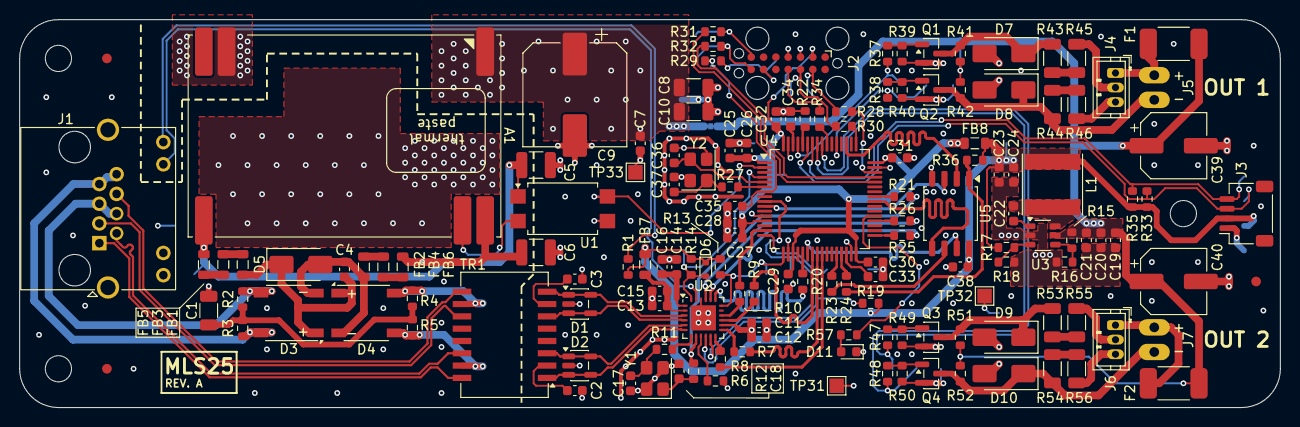
[picture p9: board mls25.kicad_pcb from above]

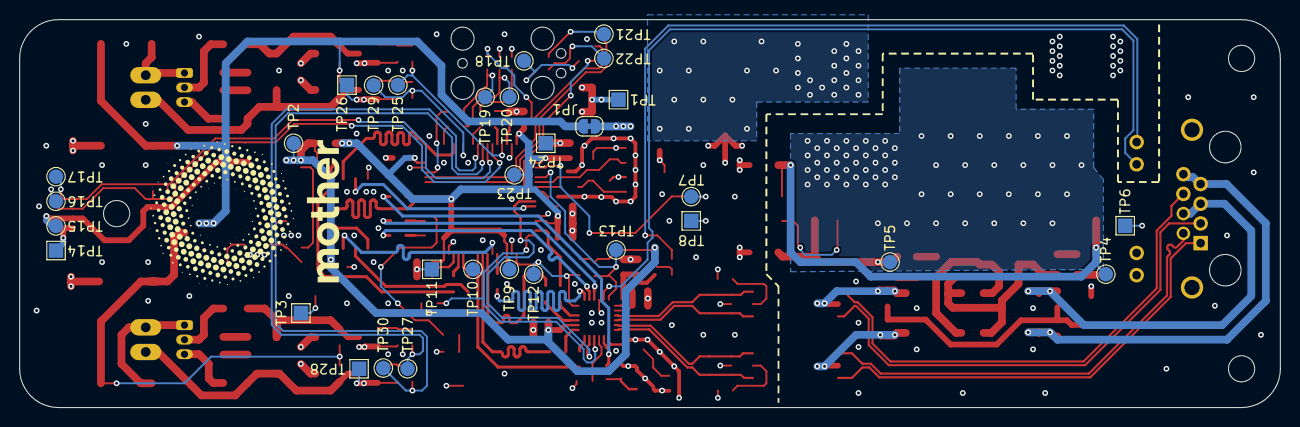
[picture p10: board mls25.kicad_pcb from below]

Board: 4 copper layers, 130.0 x 40.0 mm, 179 parts (31 on the bottom side), 114 nets.
