motherdeveloper/mother-mls25-hw/(commit log)

2025-07-25 Initial version of MLS12 schematic
    [mls12.kicad_pcb, mls12.kicad_sch, mls12_buck_3v3.kicad_sch, mls12_eth_conn.kicad_sch, mls12_eth_phy.kicad_sch, mls12_eth_poe.kicad_sch, mls12_led_output.kicad_sch, mls12_mcu.kicad_sch]
2025-07-26 Update to 25W PoE+ module, 2 outputs
    [mls12.kicad_sch, mls12_buck_3v3.kicad_sch, mls12_eth_conn.kicad_sch, mls12_eth_phy.kicad_sch, mls12_eth_poe.kicad_sch, mls12_led_output.kicad_sch, mls12_mcu.kicad_sch, mls12_nor_flash.kicad_sch]
2025-07-30 Fix default footprint for PoE+ magnetics
    [mls12_eth_conn.kicad_sch]
2025-07-30 Add polyfuse footprint
    [mls12_led_output.kicad_sch]
2025-07-31 Layout LED outputs, I2C connector
    [mls12.kicad_pcb]
2025-08-01 First Ethernet frontend layout
    [mls12.kicad_pcb, mls12_eth_conn.kicad_sch]
2025-08-02 Allow MDI DPs to be routed through TVS free pins
    [mls12_eth_conn.kicad_sch]
2025-08-27 Initial RMII, MDIO routing
    [mls12.kicad_pcb, mls12_eth_phy.kicad_sch, mls12_mcu.kicad_sch, mls12_nor_flash.kicad_sch]
2025-09-02 Route NOR flash QSPI traces
    [mls12.kicad_pcb]
2025-09-03 Route MCU decoupling caps
    [mls12.kicad_pcb]
2025-09-06 Layout buck converter, position TagConnect
    [mls12.kicad_pcb]
2025-09-06 Add missing connector, inductor STEPs
    [mls12.kicad_pcb, mls12_mcu.kicad_sch]
2025-09-06 Route +24V
    [mls12.kicad_pcb]
2025-09-06 Route +3V3
    [mls12.kicad_pcb, mls12_mcu.kicad_sch]
2025-09-06 Route low-speed signals
    [mls12.kicad_pcb]
2025-09-08 Route PHY +3V3
    [mls12.kicad_pcb]
2025-09-09 Route PHY IRQ
    [mls12.kicad_pcb, mls12.kicad_sch, mls12_mcu.kicad_sch]
2025-09-09 Adjust QSPI length matching
    [mls12.kicad_pcb]
2025-09-09 Add blinky LED
    [mls12.kicad_pcb, mls12_mcu.kicad_sch]
2025-09-09 Xtal layout, guard rings
    [mls12.kicad_pcb]
2025-09-10 Ground return vias
    [mls12.kicad_pcb]
2025-09-10 Add mounting holes, round corners
    [mls12.kicad_pcb, mls12.kicad_sch]
2025-09-19 Add power planes, fiducials
    [mls12.kicad_pcb, mls12.kicad_sch]
2025-09-21 Add test points
    [mls12.kicad_pcb, mls12_buck_3v3.kicad_sch, mls12_eth_phy.kicad_sch, mls12_eth_poe.kicad_sch, mls12_led_output.kicad_sch, mls12_mcu.kicad_sch, mls12_nor_flash.kicad_sch]
2025-09-27 Cleanup silkscreen, add logo
    [mls12.kicad_pcb]
2025-09-27 Rename `mls12` to `mls25`
    Module output was changed from 12W to 25W during the course of development.
    Update filenames to reflect that.
    [mls25.kicad_pcb, mls25.kicad_sch, mls25_buck_3v3.kicad_sch, mls25_eth_conn.kicad_sch, mls25_eth_phy.kicad_sch, mls25_eth_poe.kicad_sch, mls25_led_output.kicad_sch, mls25_mcu.kicad_sch]
2025-09-30 Fix ERC warnings/errors
    * Add NC-flags to microcontroller pins.
    * Fix STM32 VCAP, ~RESET pin type.
    * Add PWR_FLAG symbols.
    [mls25.kicad_pcb, mls25.kicad_sch, mls25_buck_3v3.kicad_sch, mls25_eth_conn.kicad_sch, mls25_eth_phy.kicad_sch, mls25_eth_poe.kicad_sch, mls25_led_output.kicad_sch, mls25_mcu.kicad_sch]
2025-10-04 Tweaks/fixes after design review
    * Fix RJ45 refdes on silkscreen.
    * Change PHY IRQ pullup from 1K to 4K7 per datasheet recommendations.
    * Add skew correction on MDI TX differential pair.
    * Remove copper under magnetics.
    * Add annotation that TYP2_DET signal requires MCU internal pullup.
    [mls25.kicad_pcb, mls25_eth_phy.kicad_sch, mls25_mcu.kicad_sch]
2025-10-04 Change PHY to datasheet recommended footprint
    Default footprint in the Kicad libraries for KSZ8081 deviates from the
    datasheet recommendations. QFN parts can be fiddly, so it's best to stick
    closely to the recommendations:
    * Pads are much shorter and a bit thinner.
    * Solder stencil openings for exposed pad are smaller, spaced out a bit less.
    [mls25.kicad_pcb, mls25_eth_phy.kicad_sch]
2025-10-07 Change output polyfuse from 500mA to 750mA
    [mls25.kicad_pcb, mls25_led_output.kicad_sch]
2025-10-21 Exclude test pads from BOM
    [mls25_buck_3v3.kicad_sch, mls25_eth_phy.kicad_sch, mls25_eth_poe.kicad_sch, mls25_led_output.kicad_sch, mls25_mcu.kicad_sch, mls25_nor_flash.kicad_sch]
2025-10-21 Set origin, change page template, link revision silkscreen to field
    [mls25.kicad_pcb]
2025-10-22 Add full MPN to buck converter IC
    [mls25_buck_3v3.kicad_sch]
2025-10-22 Update Kicad 9.0.5 footprints
    [mls25.kicad_pcb]
2025-10-22 Bump title block date
    [mls25.kicad_pcb, mls25.kicad_sch, mls25_buck_3v3.kicad_sch, mls25_eth_conn.kicad_sch, mls25_eth_phy.kicad_sch, mls25_eth_poe.kicad_sch, mls25_led_output.kicad_sch, mls25_mcu.kicad_sch]
